EdoSantu24/SplashLight/(commit log)

2025-04-06 Update SENSOR_TEAM_Initial_Worksheet.ino
    If the code is somewhat unclear, and difficult to setup pin-wise, i suggest using the former version
2025-04-06 Update SENSOR_TEAM_Initial_Worksheet.ino
    Now it contains a text based description of how the pins are wired together (hopefully it makes enough sense)
2025-04-07 Update SENSOR_TEAM_Initial_Worksheet.ino
    Threshhold functions
    React to movement
    React to Idle
    Data struct for accelerometer data
2025-04-10 Fixed error
    Fixed Struct being out of scope
    Fixed variable name
    [SENSOR_TEAM_Initial_Worksheet.ino]
2025-04-28 Added the modes
    Functioanlity for the different modes and going in and out of them. Turns off the correct external devices.
    Missing still is functionality for getting in and out of storage.
    [SENSOR_TEAM_Initial_Worksheet.ino, accelerometer.h, accelerometer.ino]
2025-04-28 added list of pins on board and their status (tells which can be given a pinmode)
2025-05-01 added sound buzzer code
    [Main.ino]
2025-05-04 commented accelerometer.ino
2025-05-04 comment accelerometer.ino
2025-05-04 commented SENSOR_TEAM_Initial_Worksheet.ino
2025-05-04 commented accelerometer.ino
    Mind: there are seven things that i have made a comment on minor things that needs addressing. if you ctrl+f, then search for #0, #1, #2, #3, #4, #5, #6
2025-05-04 Comment SENSOR_TEAM_Initial_Worksheet.ino
    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
2025-05-06 Create LED_STATUS_ONLY_SEND
2025-05-06 Update LED_STATUS_ONLY_SEND
2025-05-08 Added the z axis since it will be tilted
2025-05-08 Rename LED_STATUS_ONLY_SEND to LoraWAN code
2025-05-18 Release 1.1. Sorted code, changed variables and timers.
2025-05-24 Release 1.2, small bugfixes and changes. Deep sleep example edited
    [Deep_Sleep_Example.ino, Main.ino]
2025-10-17 Add Final report and images of the prototype
2025-10-17 Update README with design and prototype images
    Added initial design and final prototype images to README.
